Integrated-Project-2-2023-UVic-UCC/reflow-soldering/List of Materials.xlsx

PRODUCT | UNIT PRICE | UNITS | TOTAL PRICE | WEB | LINK
Converter AC/DC 5v | 3.67 | 1 | 3.67 | shoptronica | https://www.shoptronica.com/fuentes-ac-dc/5874-fuente-conmutada-ac-dc-5v-2a-36x17mm-0689593940483.html
convertidor ac dc 5, 12 | 3.25 | 1 | 3.25 | aliexpres | https://es.aliexpress.com/item/1005004882184300.html?_t=pvid%3A0c7acc52-9918-41fa-87ab-2f479e853282
Sintetic wool Aisolaytor with an aluminium paper on top
Relay SSR 220v-5v | 9.99 | 1 | 9.99 | Amazon | https://www.amazon.es/Diymore-M%C3%B3dulo-Arduino-24V-380V-SSR-40DA/dp/B08FWWRK2Y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
Termistor 100 ohms, 300ºC | 1.61 | 1 | 1.61 | aliexpres | https://es.aliexpress.com/item/32436136885.html?_t=pvid%3A84f9d991-ff43-4abf-a58f-0a8a653c939a
AC port | 1.14 | 1 | 1.14 | shoptronica | https://www.shoptronica.com/conectores-de-enchufes-clavijas-de-luz-iec/5358-base-enchufe-de-luz-iec-60320-macho-cs-8944748458223.html
Arduino uno |  | 1 | 0 | Rspro | https://es.rs-online.com/web/p/arduino/7154081?tpr=1
Hot plate 500W | 10.3 | 1 | 10.3 | shoptronica | https://www.shoptronica.com/circuitos-electronicos/6020-placas-de-calentamiento-para-soldar-led-star-220v-0689594049628.html
LSD Screen 16x2 | 3.59 | 1 | 3.59 | solectro | https://solectroshop.com/es/pantalla-lcd/739-pantalla-lcd-16x2-1602-hd44780-retroiluminado-fondo-azul.html
