Integrated-Project-2-2023-UVic-UCC/reflow-soldering/Assembly.stp

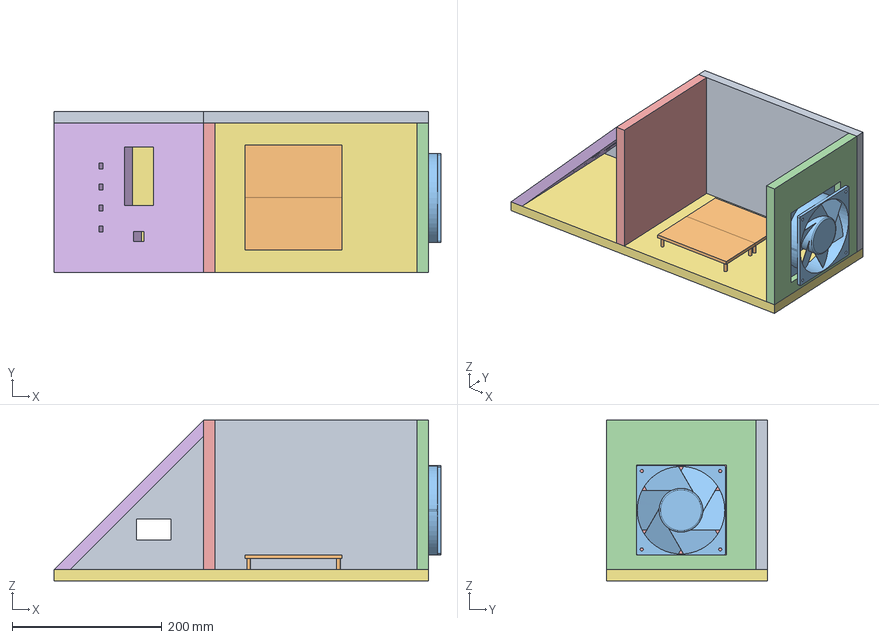
[picture p14: CAD file, 2023-06-04]
Assembly.stp
517.0 x 215.0 x 215.0 mm
Tapa lateral
Placa soldadura x 2
Ventilador
Soport ventilador
Soport panell
Panell control
Base
