Integrated-Project-2-2023-UVic-UCC/reflow-soldering/SideCover.stp

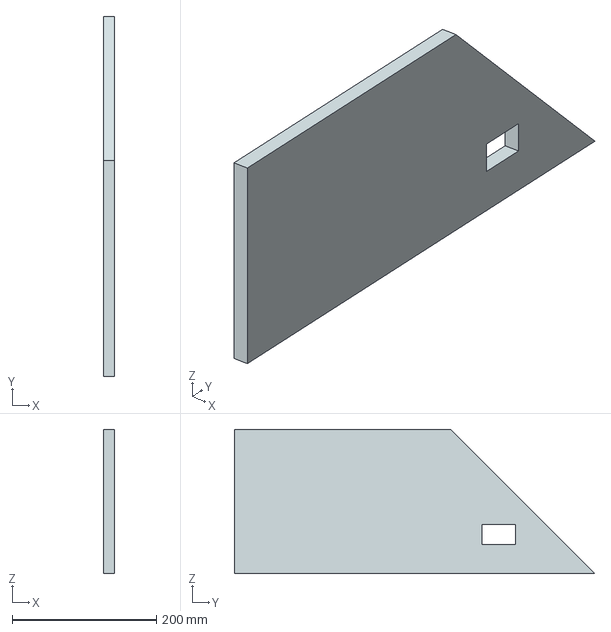
[picture p15: CAD file, 2023-06-04]
SideCover.stp
15.0 x 500.0 x 200.0 mm
