Integrated-Project-2-2023-UVic-UCC/reflow-soldering/Base (2).stp

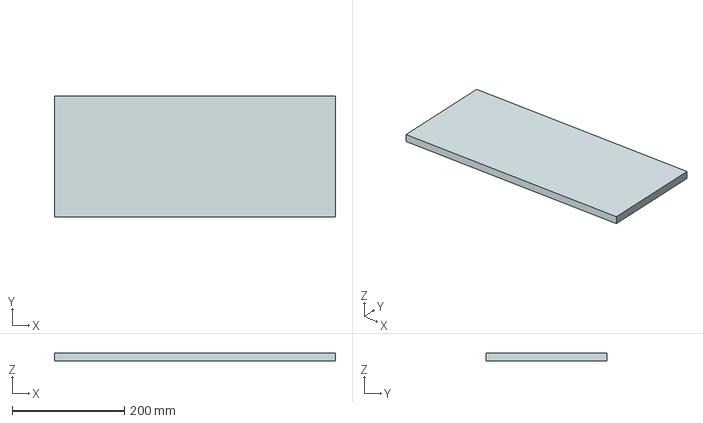
[picture p16: CAD file, 2023-06-04]
Base (2).stp
500.0 x 215.0 x 15.0 mm
