Integrated-Project-2-2023-UVic-UCC/reflow-soldering/plug.stl

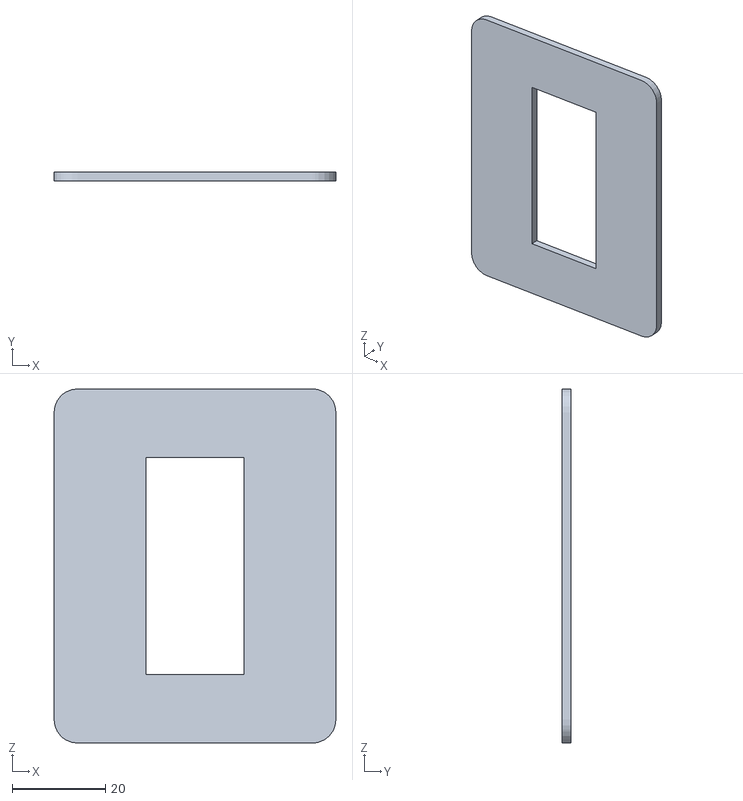
[picture p17: CAD file, 2023-06-04]
plug.stl
60.5 x 2.00 x 76.0
