Integrated-Project-2-2023-UVic-UCC/reflow-soldering/ControlPanel.stp

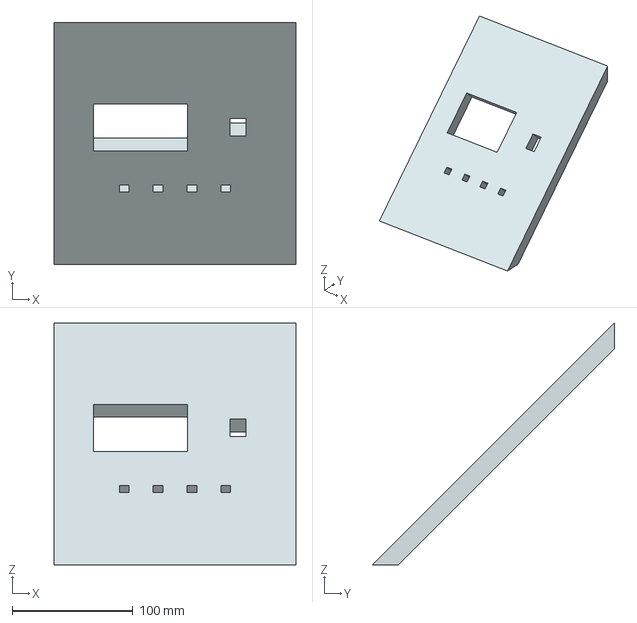
[picture p18: CAD file, 2023-06-04]
ControlPanel.stp
200.0 x 200.0 x 200.0 mm
