Integrated-Project-2-2023-UVic-UCC/reflow-soldering/FanSupport.stp

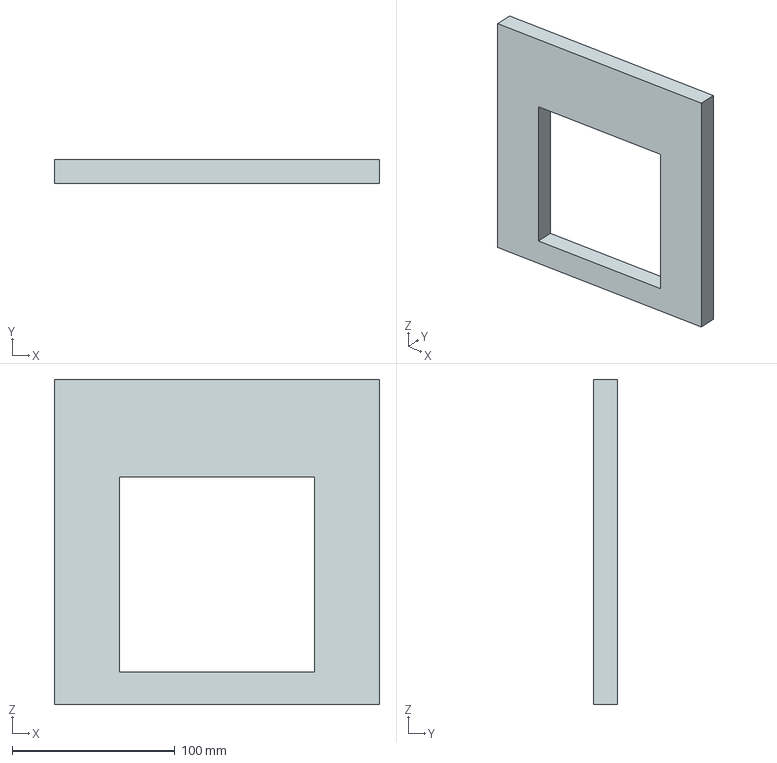
[picture p19: CAD file, 2023-06-04]
FanSupport.stp
200.0 x 15.0 x 200.0 mm
