Integrated-Project-2-2023-UVic-UCC/reflow-soldering/HotPlate.stp

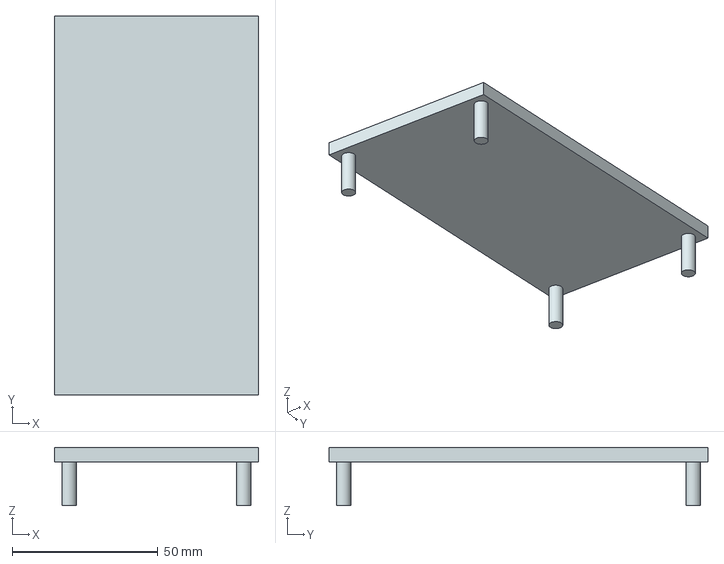
[picture p20: CAD file, 2023-06-04]
HotPlate.stp
70.0 x 130.0 x 20.0 mm
