Integrated-Project-2-2023-UVic-UCC/reflow-soldering/Fan.stp

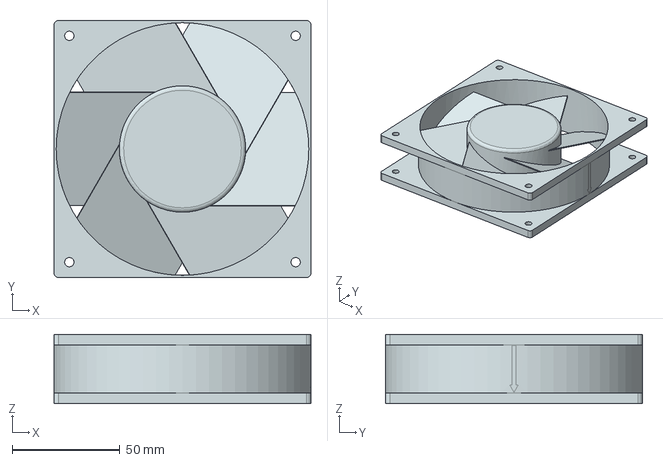
[picture p21: CAD file, 2023-06-04]
Fan.stp
119.0 x 119.0 x 32.0 mm
