Integrated-Project-2-2023-UVic-UCC/reflow-soldering/ControlPanel (2).stp

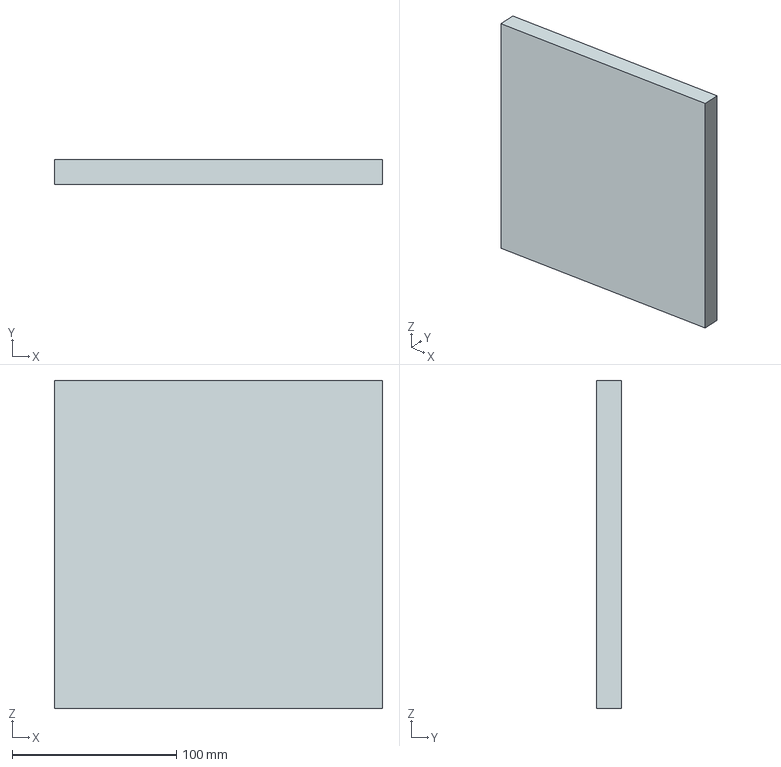
[picture p22: CAD file, 2023-06-04, an earlier design]
ControlPanel (2).stp
200.0 x 15.0 x 200.0 mm
