Integrated-Project-2-2023-UVic-UCC/reflow-soldering/HotPlate_UserManual.pdf

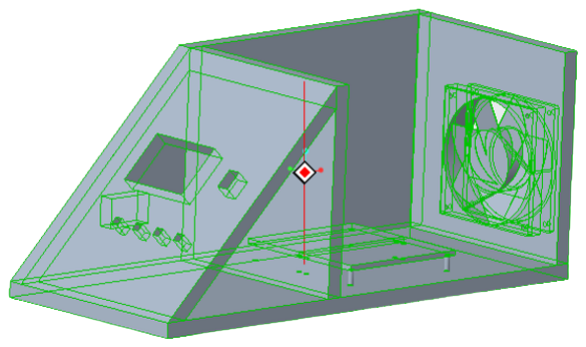
[picture p23: figure]

# REFLOWING HOT PLATE MACHINE

I N T E G R A T E D P R O J E C T II

SAFETY WARINIGS | HOW TO USE IT

Use only for soldering psb
components

If one of the hot plates breaks or cracks, unplug it immediately to avoid electric shock.

This appliance is not designed to operate with an external timer (not built into the appliance) or a separate remote control system.

The device and its accessible parts may become hot during operation, avoid touching the heating elements.

Children under 8 years of age should be kept away from the hob unless they are under constant supervision. They should ONLY use the device under supervision or if they have received proper instructions on how to use the device and understand its dangers.

Do not store objects in the hot plates.

If the power cord is damaged, it must be replaced.

Put the device that
requires welding on the
plate and apply the
corresponding fixing
paste

1

Close the protective

2

cover to the user

Correctly connect the
power inlet and switch
on the device

3

Wait for the welding
process to finish.
From the screen it will
be indicated going back
to the main menu

4

# MORE INFO

# MANTEINANCE

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

CARRER DE LA LAURA, 13, 08500 VIC

|EN| Instructions for use, manteinance and safety warnings.

Do not steam clean this device.

Cleaning and maintenance must not be carried out by children without supervision. Children must not play with the device.

The device requires superficial cleaning after each use with dry and moisture-free utensils.
