Integrated-Project-2-2023-UVic-UCC/reflow-soldering/(threads)

Thread 1 (2023-02-16):

Things missing

JuniperSans, 2023-02-16:
- [ ] shopping list
- [ ] Cad design
- [ ] Start documentation

Thread 4 (2023-02-16):

Design of the circuit

Ana343Carolina, 2023-02-16:
Doing the design of the circuit on CircuitLab and maybe Tinkercad(just for having an ideia about how's going to work with the arduino)

Ana343Carolina, 2023-03-08:
- [ ] Put all the components according to the project
- [ ] Design the ones that are missing in the general library
- [ ] Connect all the components correctly
- [ ] Put the symbols if necessary
- [ ] Adding in the library the components that are missing if necessary

JuniperSans, 2023-03-08:
As we may change the hot plate component, we may consider that the circuit could have some modifications.

Ana343Carolina, 2023-03-09:
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

Change the thermistor to a termopar MAX6675

Ana343Carolina, 2023-03-13:
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
For now, the circuit it is like this. Maybe I have to change the buttoms connected to arduino, but I don't know yet whichport is going to be connected

Ana343Carolina, 2023-03-16:
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
I've changed the names that were wrong, I still have to change the name of the dispaly baord, but it is on my library and I'm trying to figure out how to do it wihtout deleting and making again the connections.

Ana343Carolina, 2023-03-28:
There is some changes between the display board and the arduíno. It´s going to have resistor between some ports.
Also the relay was connected on a wrong way, so it has some changes

Ana343Carolina, 2023-03-28:
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

Ana343Carolina, 2023-03-28:
I need to find a way to connect the resistors between the display board and the arduino
(all the ports that are connected are correct, is just missing the resistors)

Ana343Carolina, 2023-03-28:
Also the buttoms are just to represent, in the next weeks when we connect them I will change on KiCad

Ana343Carolina, 2023-04-13:
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

I started the connexions between the display and the arduino, with all the pins and the resistors between then. I will try to rearange to make a bigger space between the arduino and the display board, to not look so messy.
I also get done the transistor connected to the relay, but is missing the part to connect to arduino.

Ana343Carolina, 2023-04-20:
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

Final circuit, but if would have any change I will do it again

Ana343Carolina, 2023-05-04:
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

this is the final schematic, all connected correctly

Ana343Carolina, 2023-05-04:
Alerady upload on Code

Thread 7 (2023-02-22):

Input/output device idea

moises-garin, 2023-02-22:
I would like you to consider to use a screen in your project instead of a simple text display. In particular have a look at the following screens (similar but different size):
[https://www.adafruit.com/product/2050](https://www.adafruit.com/product/2050)
[https://www.adafruit.com/product/1770](https://www.adafruit.com/product/1770)

These might be nice to show graphically the temperature profile and, since they are touch sensitive, also for the user input (no need for buttons). In principle these should be compatible with both, arduino and ESP.

Thread 15 (2023-02-28):

Design of the circuit

Ana343Carolina, 2023-02-28:

Ana343Carolina, 2023-03-08:
- Puting all the components on kicad (look for the most likely ones)
- Editing the symbols
- Do the connection between the components

Ana343Carolina, 2023-03-28:
[hot-plate-kicad-2023-03-26_211435.zip](https://github.com/Integrated-Project-2-2023-UVic-UCC/reflow-soldering/files/11090508/hot-plate-kicad-2023-03-26_211435.zip)

Thread 17 (2023-02-28):

Create a simple program

Ana343Carolina, 2023-02-28:

JuniperSans, 2023-03-08:
I've search on different PID programs for controling temperature and, i know how to control the graphics part

Thread 23 (2023-03-09):

Research information about the LCD screen

JuniperSans, 2023-03-09:
Model: *3'2 TFT SPI 240x320 V2.0*

- [ ] Showing graphics
- [ ] Touching

Ana343Carolina, 2023-05-02:
We succeded on the touching part, we made a program that we can choose the type of alloy and also shows the time and the temperature.

Thread 24 (2023-03-09):

Base CAD Design

JuniperSans, 2023-03-09:

Ana343Carolina, 2023-04-25:
In the last weeks we changed the design of the hot plate, for keeping all the components inside and also to have a fan in a good position that can help on the cooling process

Thread 26 (2023-03-16):

Datasheets of the components

Ana343Carolina, 2023-03-16:
Datasheet of the TERMOPAR
[MAX6675 - termopar.PDF](https://github.com/Integrated-Project-2-2023-UVic-UCC/reflow-soldering/files/10992917/MAX6675.-.termopar.PDF)

Ana343Carolina, 2023-03-16:
Datasheet of the Relay
[SSR-40DA-H-R - relay.PDF](https://github.com/Integrated-Project-2-2023-UVic-UCC/reflow-soldering/files/10992923/SSR-40DA-H-R.-.relay.PDF)

Ana343Carolina, 2023-03-16:
Datasheet of the Interruptor
[INTERRUPTOR-BALA.pdf](https://github.com/Integrated-Project-2-2023-UVic-UCC/reflow-soldering/files/10992938/INTERRUPTOR-BALA.pdf)

Ana343Carolina, 2023-04-18:
Datasheet of the Transistor
[transistor.PDF](https://github.com/Integrated-Project-2-2023-UVic-UCC/reflow-soldering/files/11263790/transistor.PDF)

Thread 28 (2023-03-17):

screen display circuit

JuniperSans, 2023-03-17:
Make a nice clean circuit and try some programs to make sure it works correctly

Ana343Carolina, 2023-05-09:
We are working on that now to adjust all the details and make a good screen that works well for our project

Thread 30 (2023-04-20):

Adding the fan to the project

Ana343Carolina, 2023-04-20:
In this part, we will add a fan to help the cooling time because it was a little bit slowly.
So if the transistor connected to the converter and the fan, we will have enough power to make the fan works and will be able to turn on and off.

Ana343Carolina, 2023-04-25:
Today we are going to test the fan with the converter and all the things connected. We have to see if our transistor are connected correctly to make sure that the 5V could get on the fan

Ana343Carolina, 2023-05-02:
All correct, the fan is connected well with the transistor and it's working as we wanted.

Thread 32 (2023-05-02):

Assembly the wood part

Ana343Carolina, 2023-05-02:
In this task, we get all the parts made by wood and assembly to have our final design of the hot plate (only the wood parts).

Ana343Carolina, 2023-05-02:
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

Ana343Carolina, 2023-05-02:
Today we started the painting part of the wood, we painted just one hand and tomorrow it will be finished the details.

Thread 37 (2023-05-09):

Assemblying the wood part with the electrical part

Ana343Carolina, 2023-05-09:
In this task we have to finish the wood part, painting, screwing and make it all look nice.

Ana343Carolina, 2023-05-09:
We already paint the wood part and screwed all.
Now we are putting the electrical stuff inside of the wood and adjusting the details.
