Integrated-Project-2-2023-UVic-UCC/reflow-soldering/temperaturegraphic.pdf

# Temperature

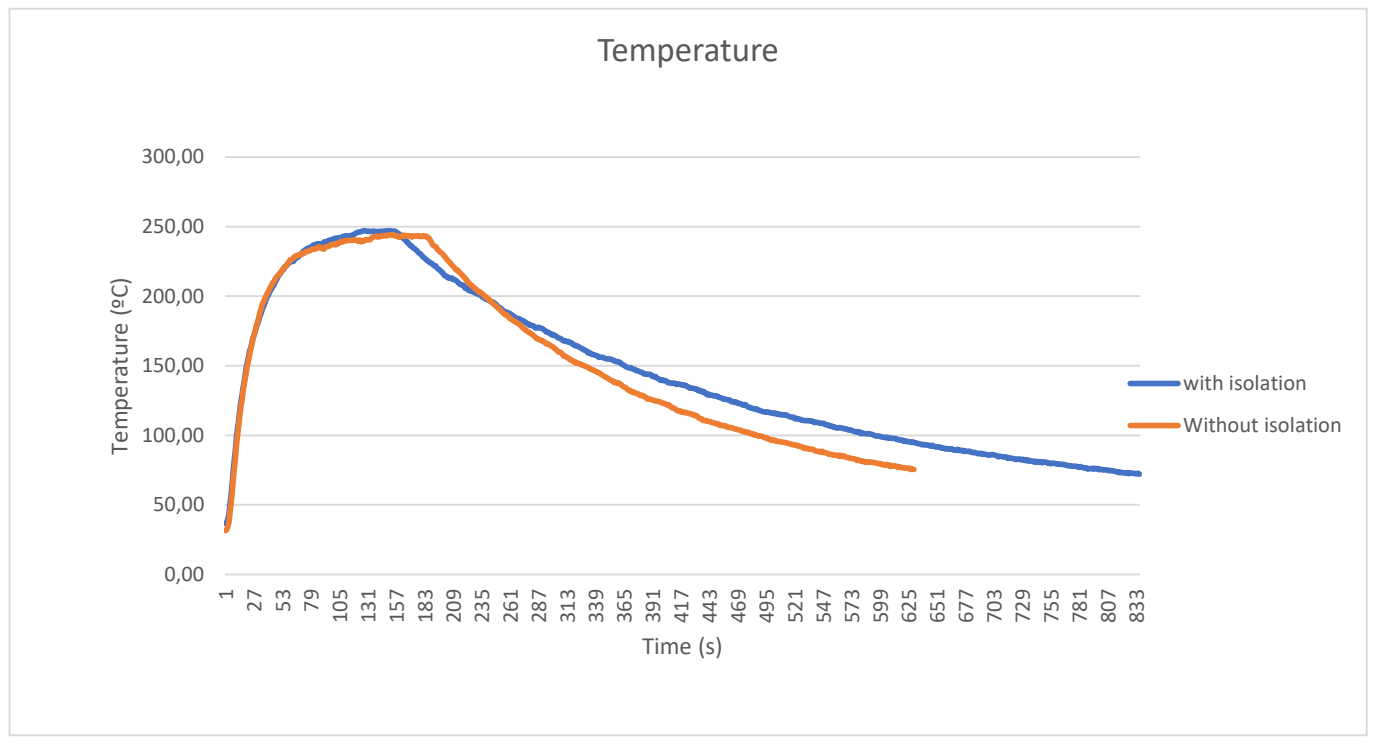
[picture p26: page 1]
Temperature (ºC); Time (s); with isolation; Without isolation
