Integrated-Project-2-2023-UVic-UCC/reflow-soldering/Base.pdf

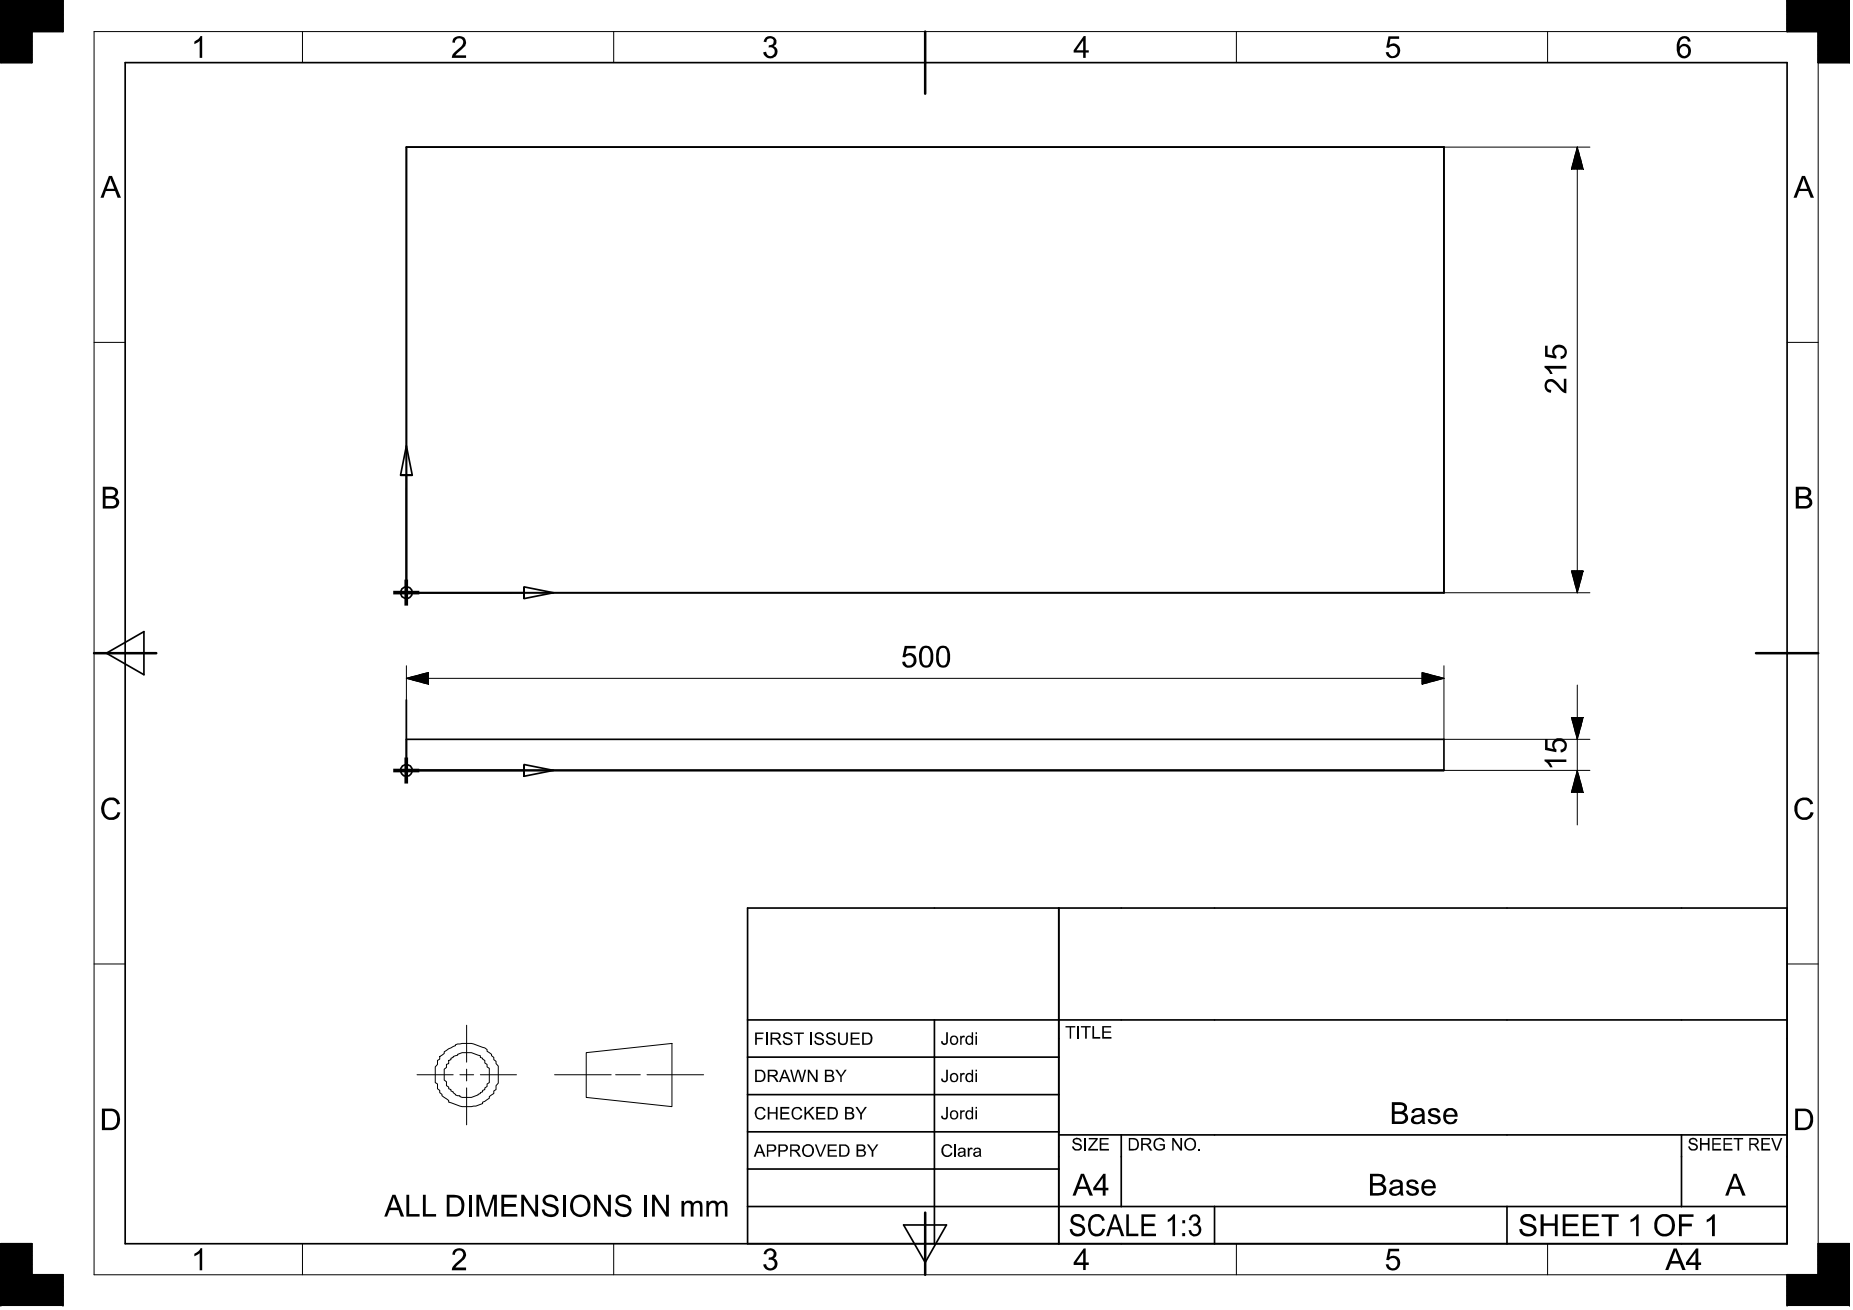
[picture p27: page 1]
