Integrated-Project-2-2023-UVic-UCC/reflow-soldering/Panell control.pdf

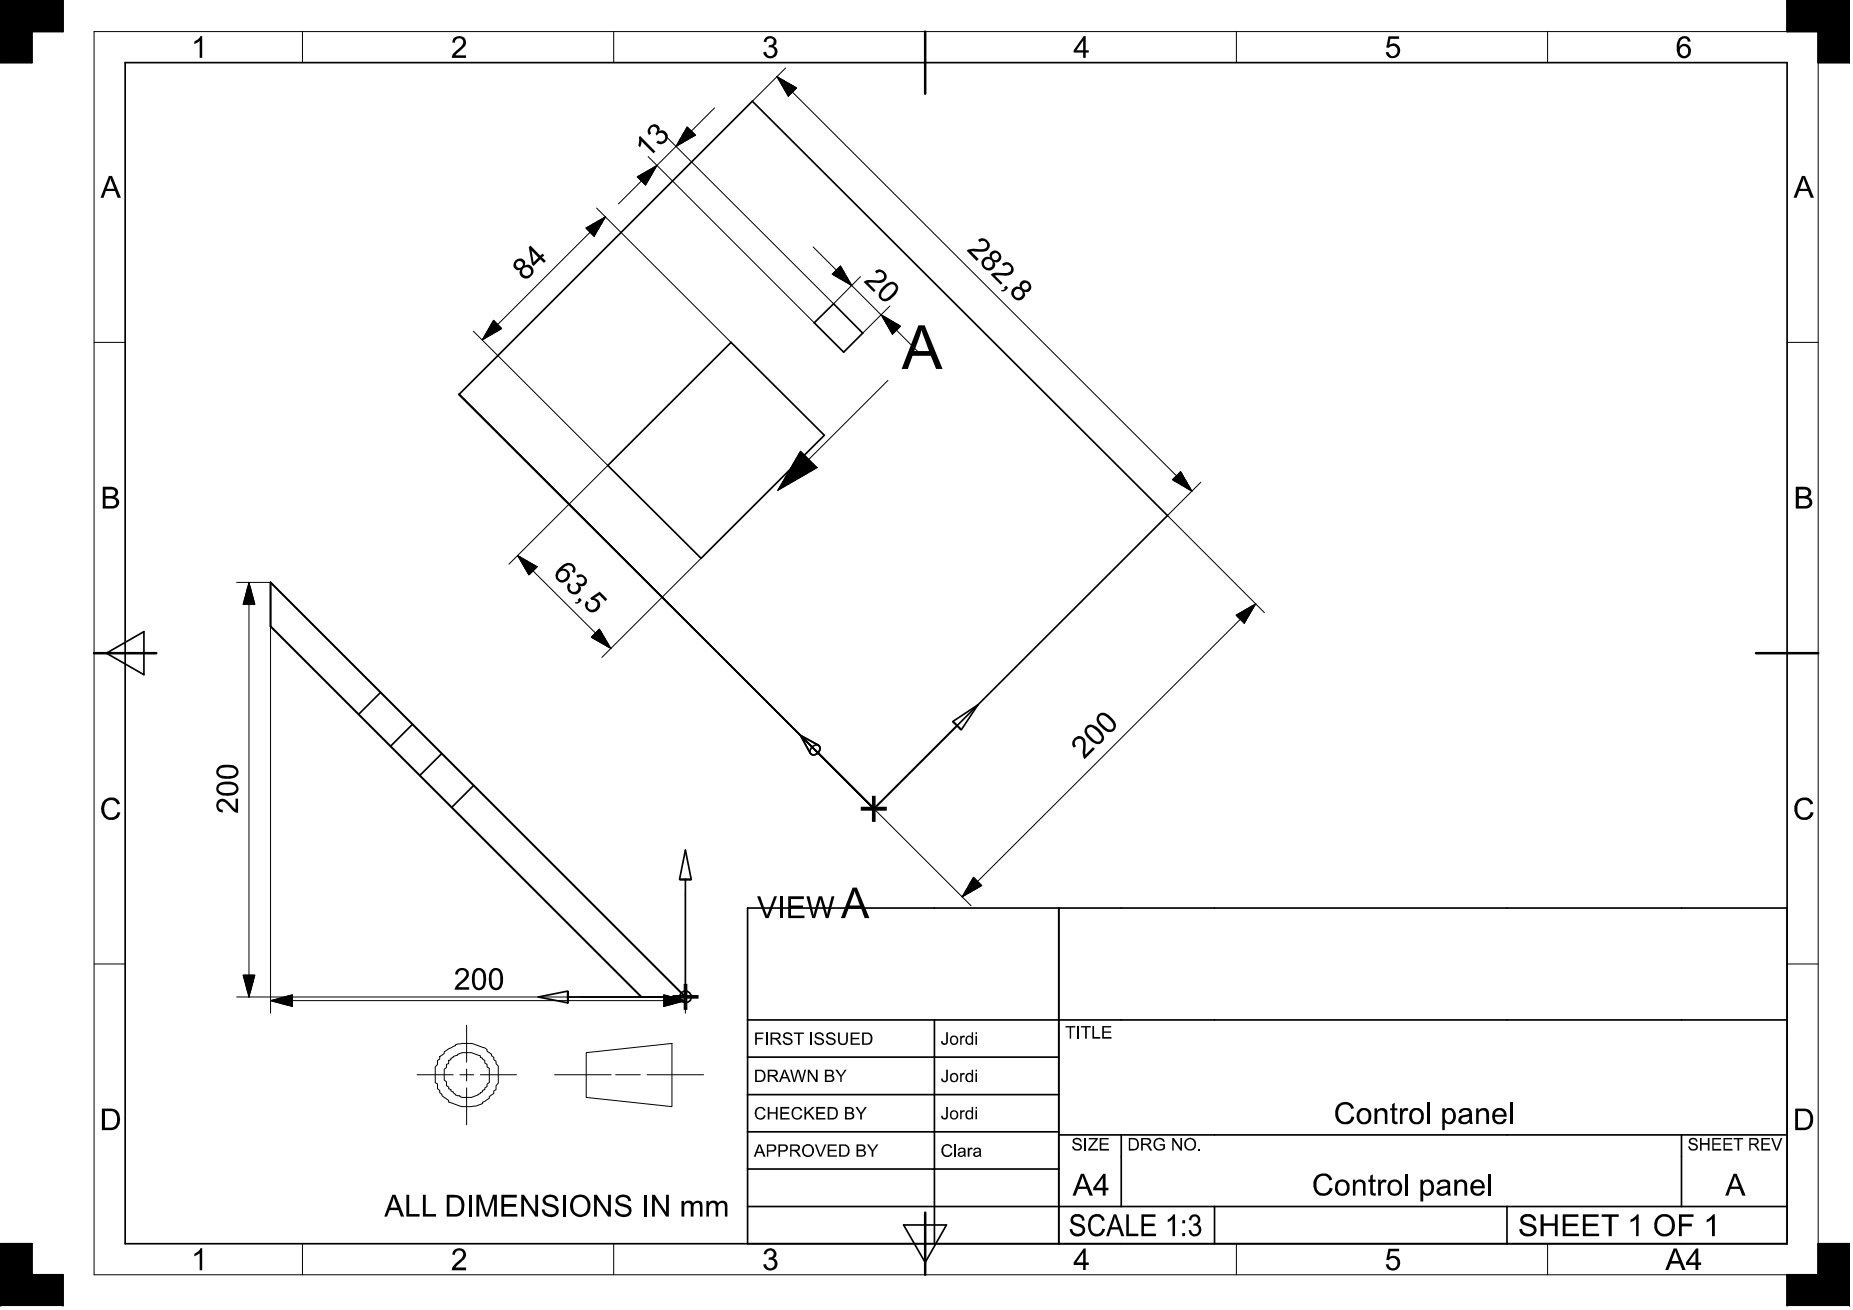
[picture p28: page 1]
