Integrated-Project-2-2023-UVic-UCC/reflow-soldering/Soport panell.pdf

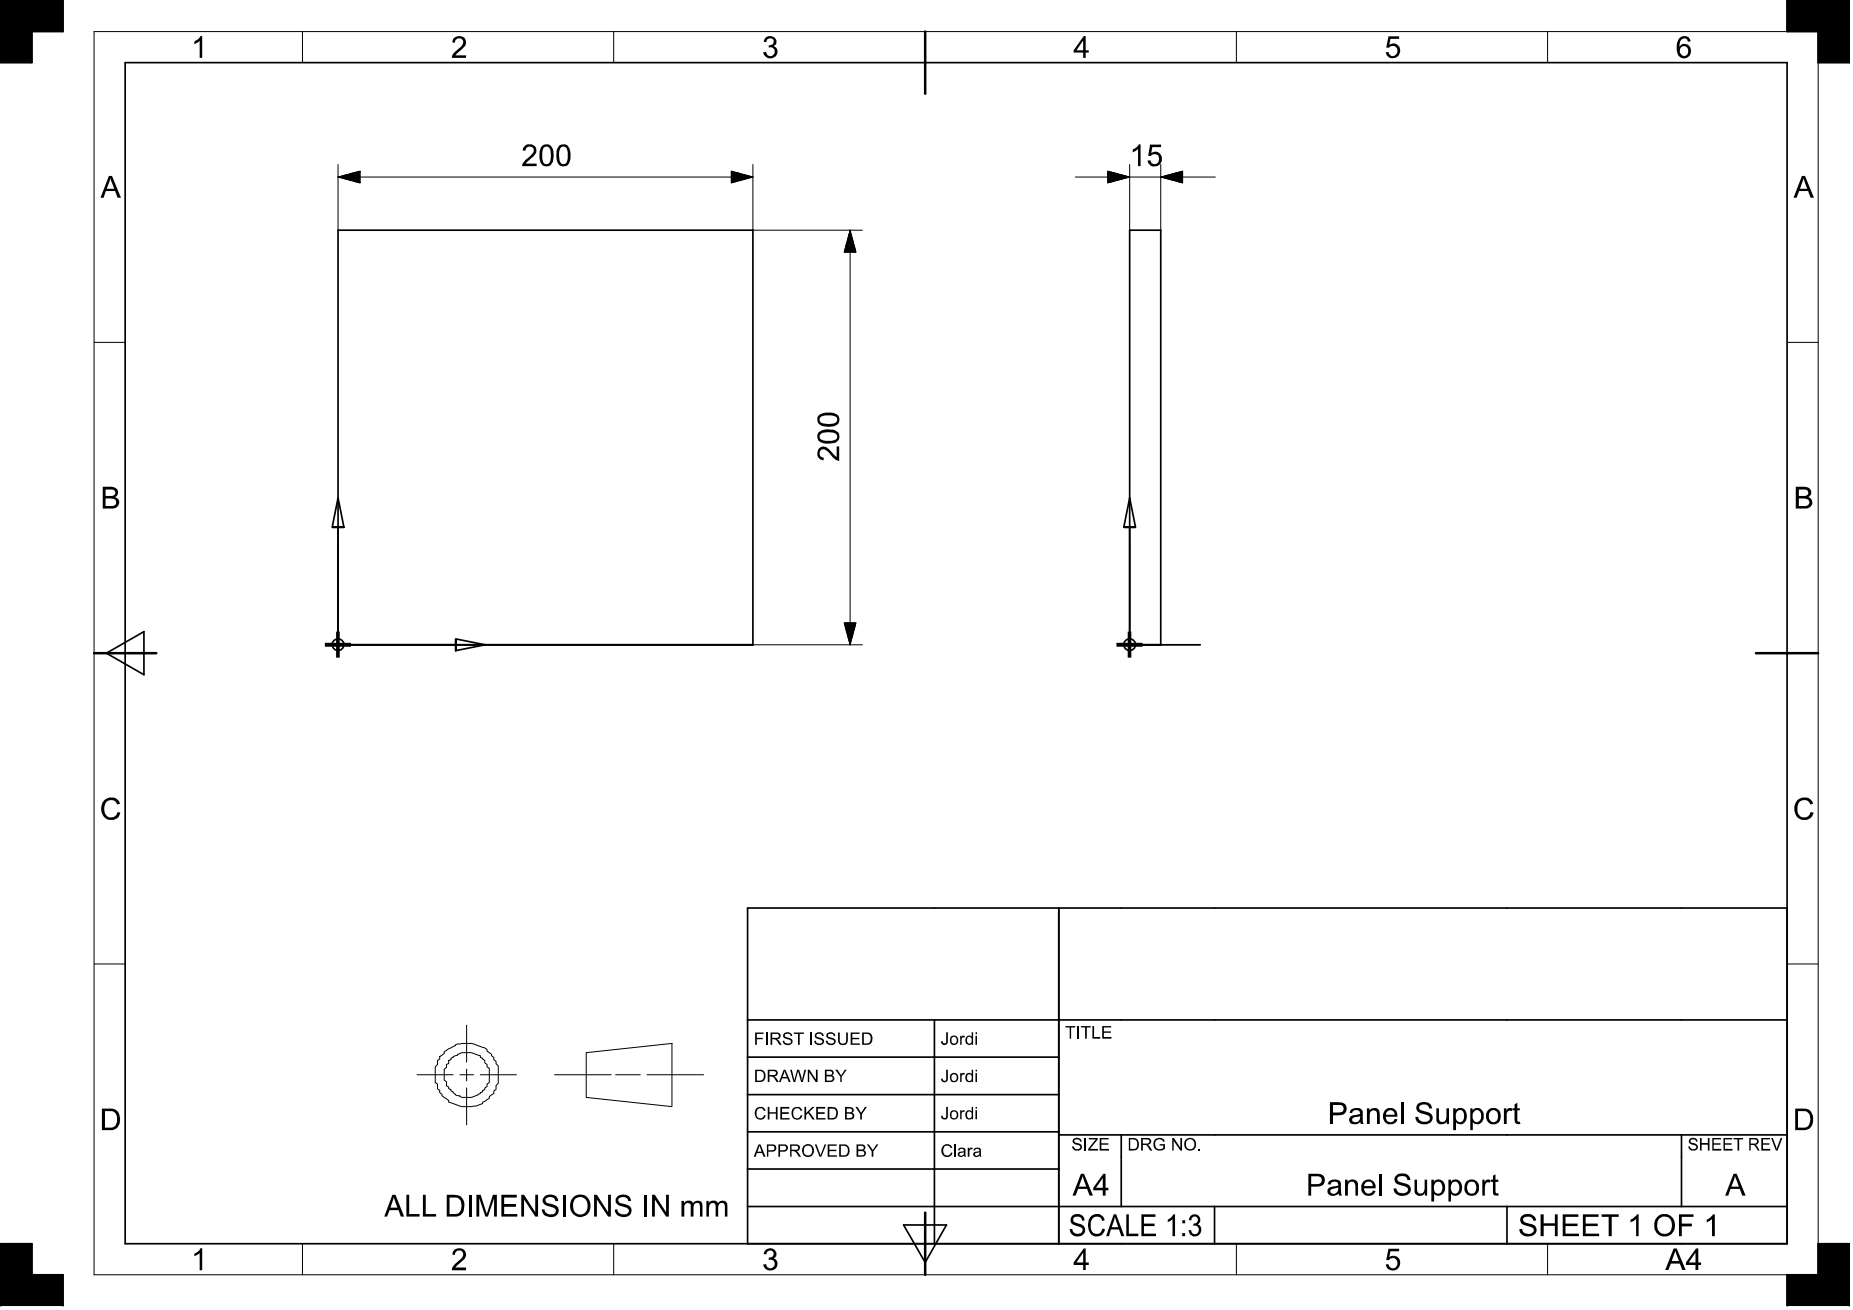
[picture p29: page 1]
