Integrated-Project-2-2023-UVic-UCC/reflow-soldering/Soport ventilador.pdf

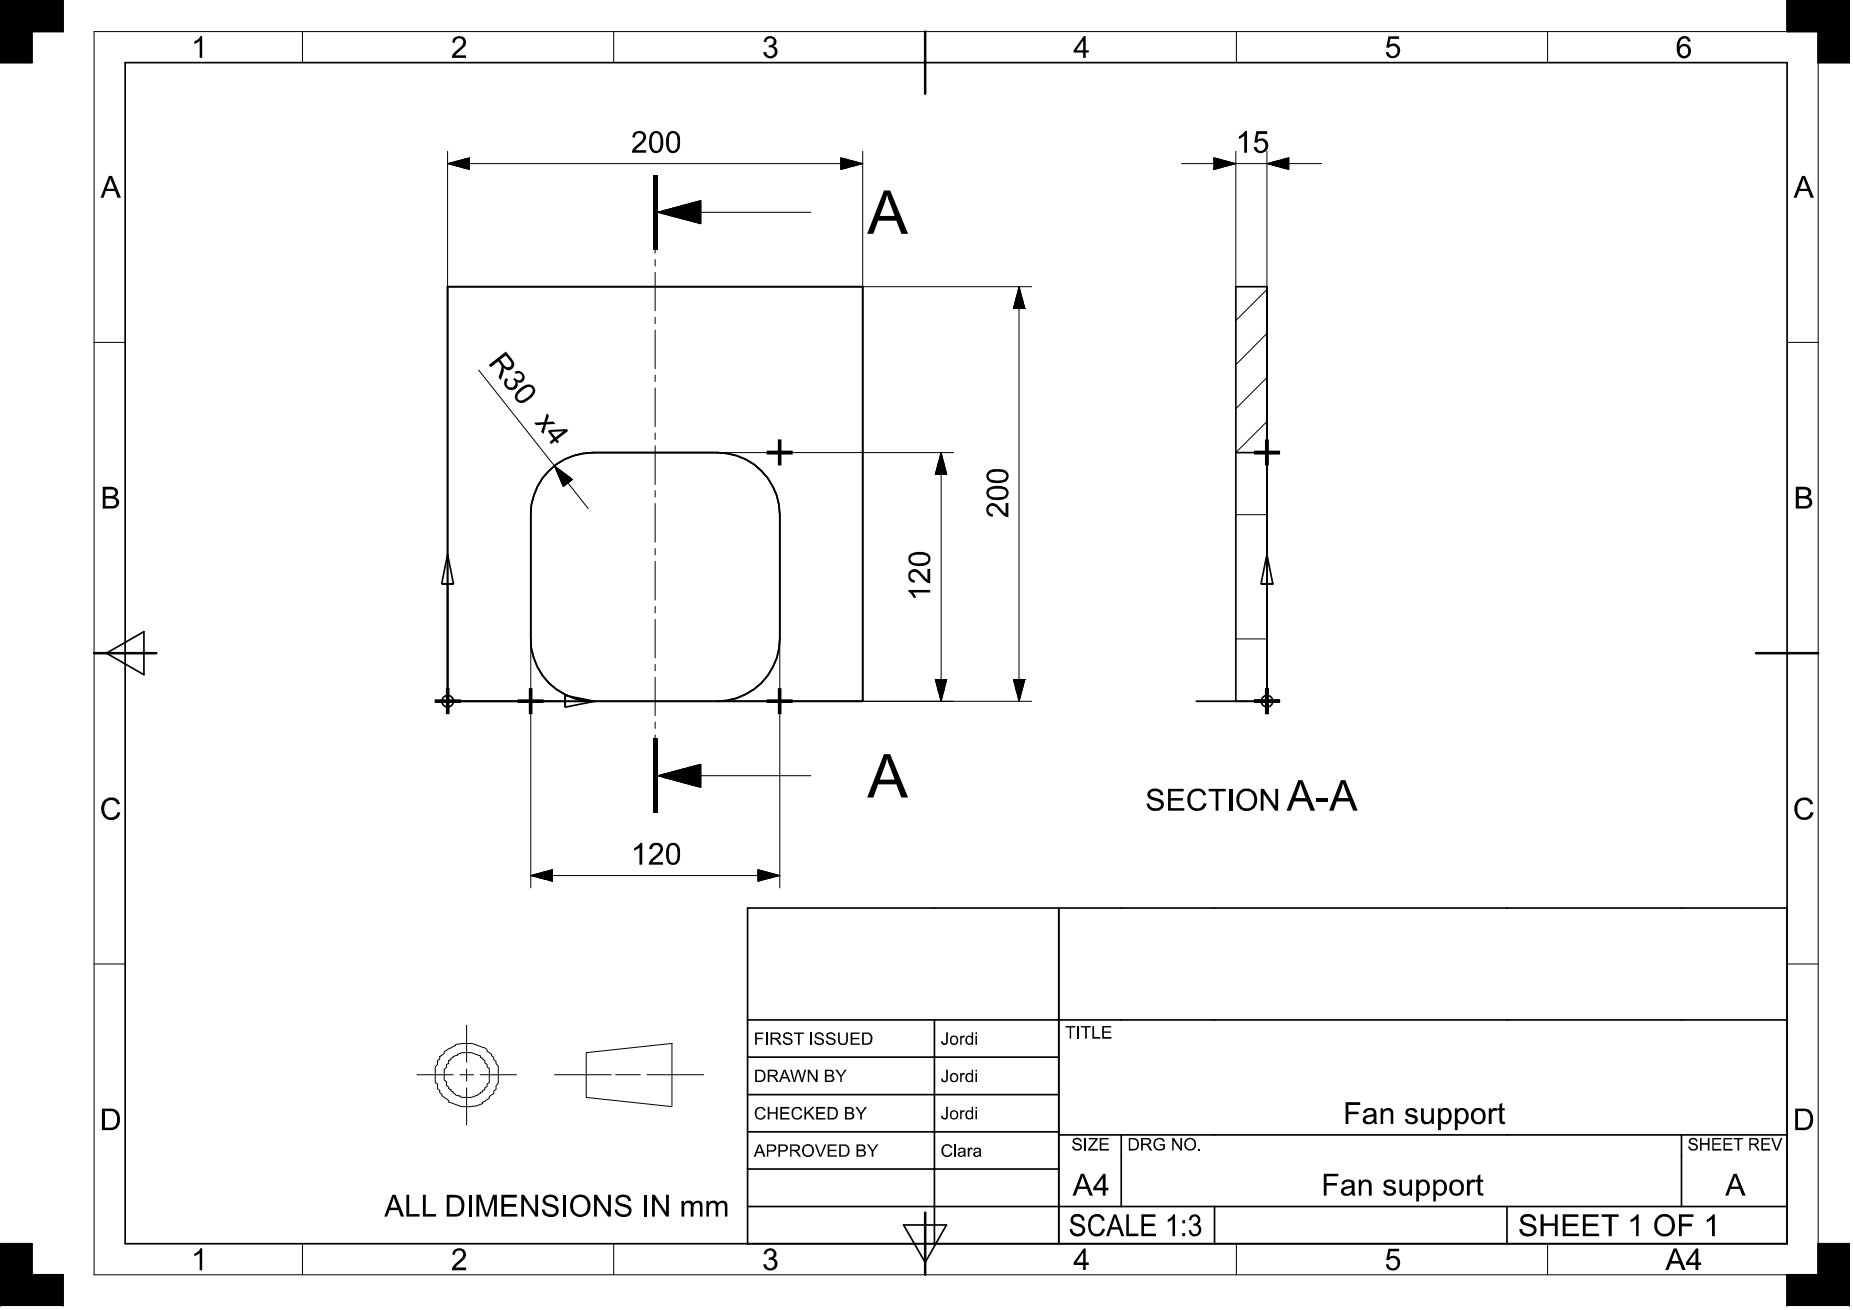
[picture p30: page 1]
