Integrated-Project-2-2023-UVic-UCC/reflow-soldering/Tapa lateral.pdf

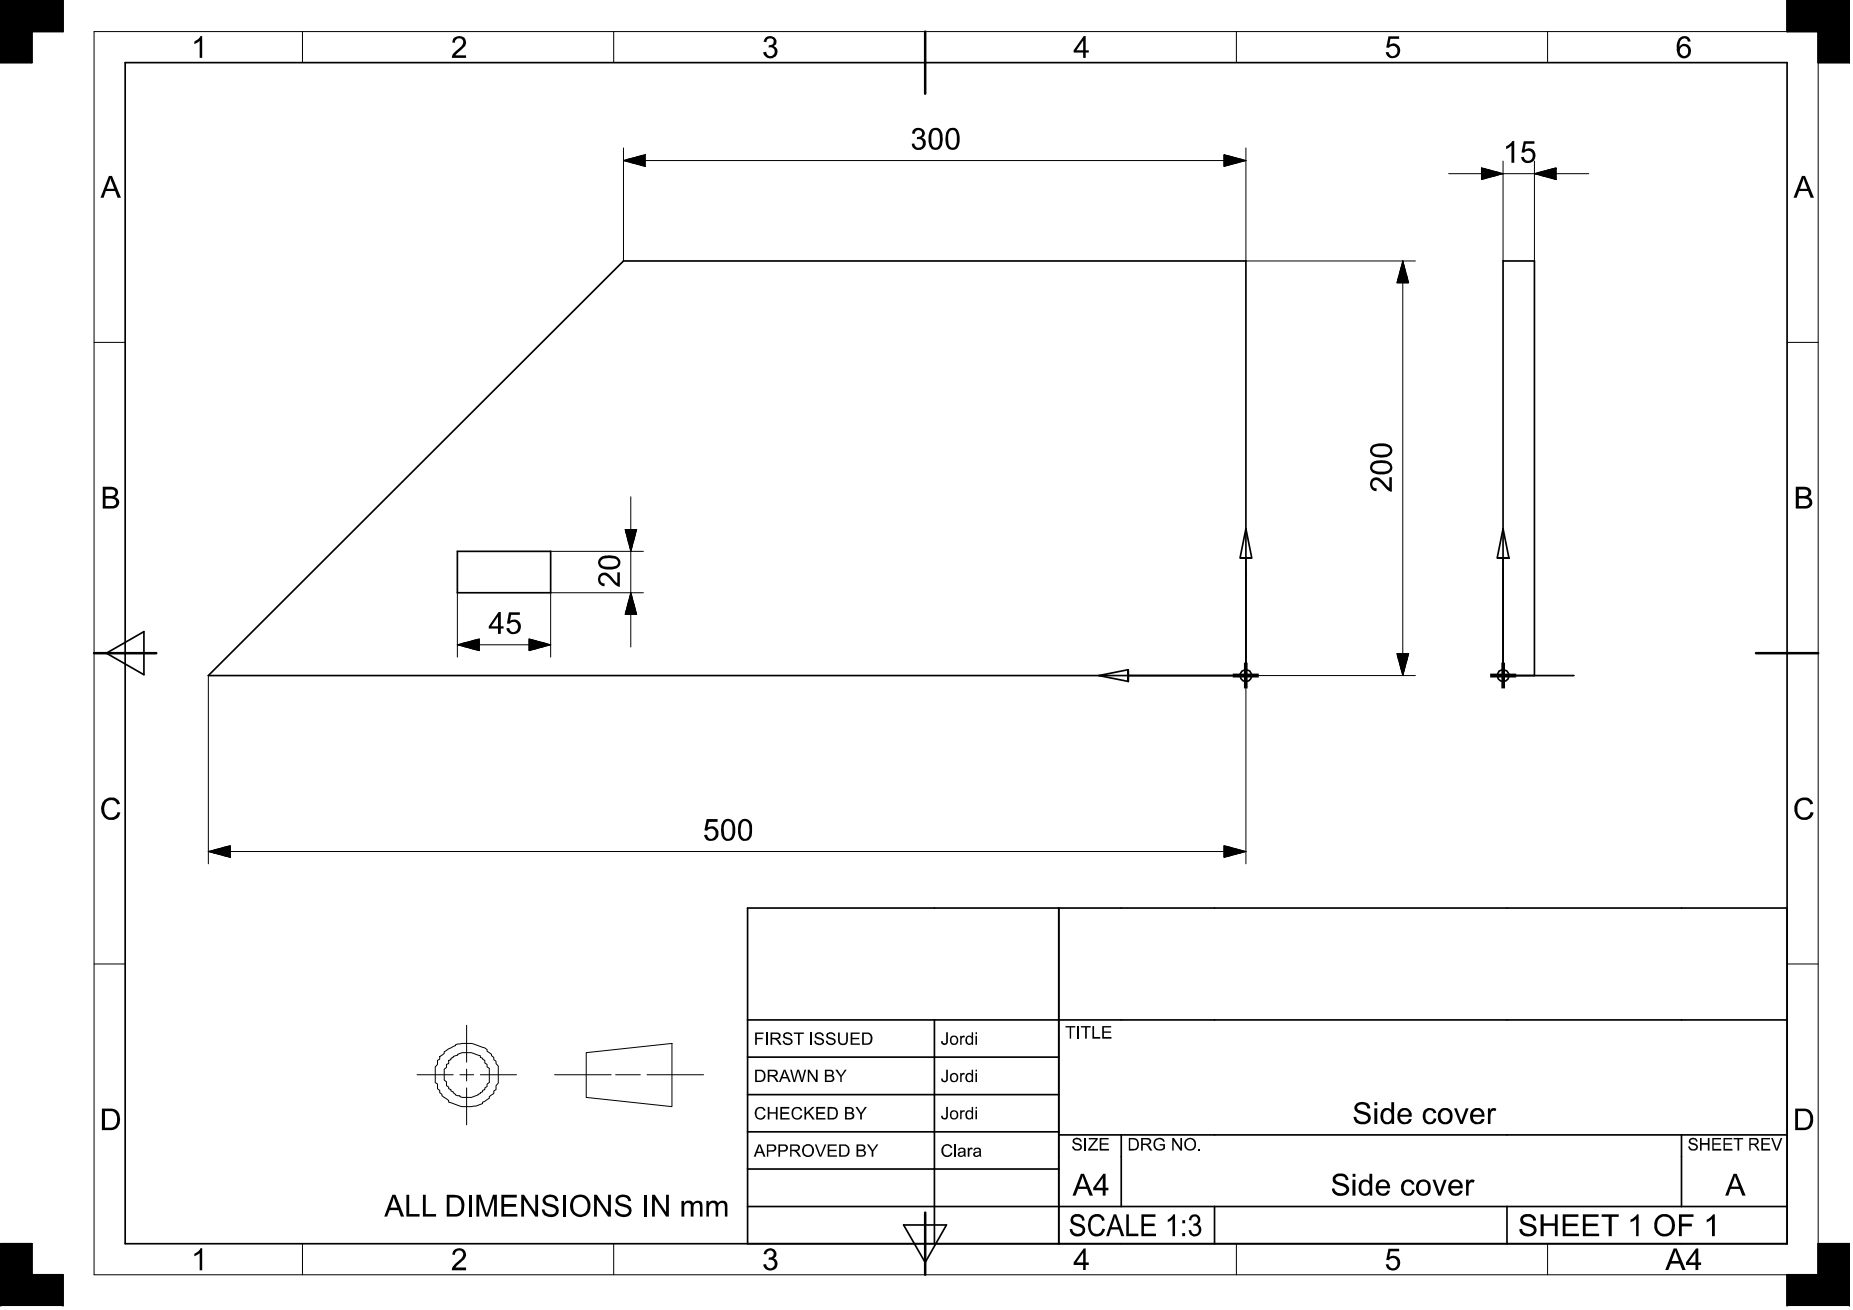
[picture p31: page 1]
