Integrated-Project-2-2023-UVic-UCC/reflow-soldering/ENGENIERINGDRAW_CASE.pdf

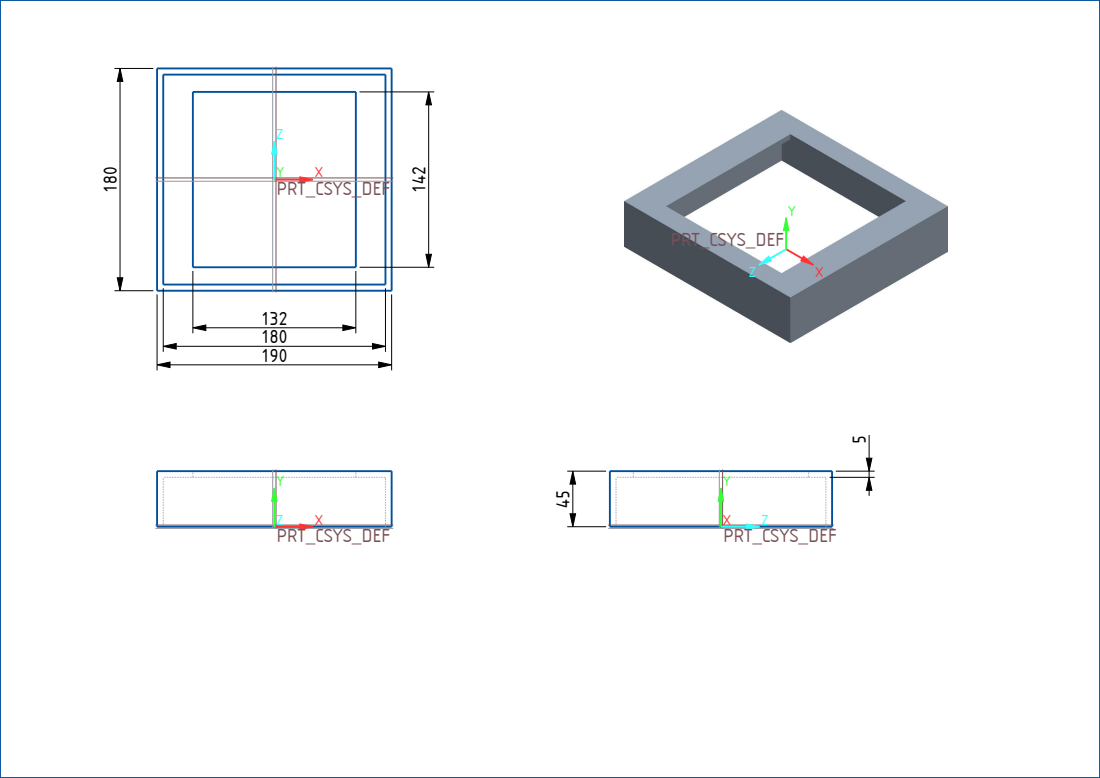
[picture p32: page 1]
PRT_CSYS_DEF; Z PRT_CSYS_DEF

PRT_CSYS_DEF
