Integrated-Project-2-2023-UVic-UCC/reflow-soldering/hot-plate-kicad_final.kicad_sch

## KiCad design hot-plate-kicad_final.kicad_sch (2023-06-05)

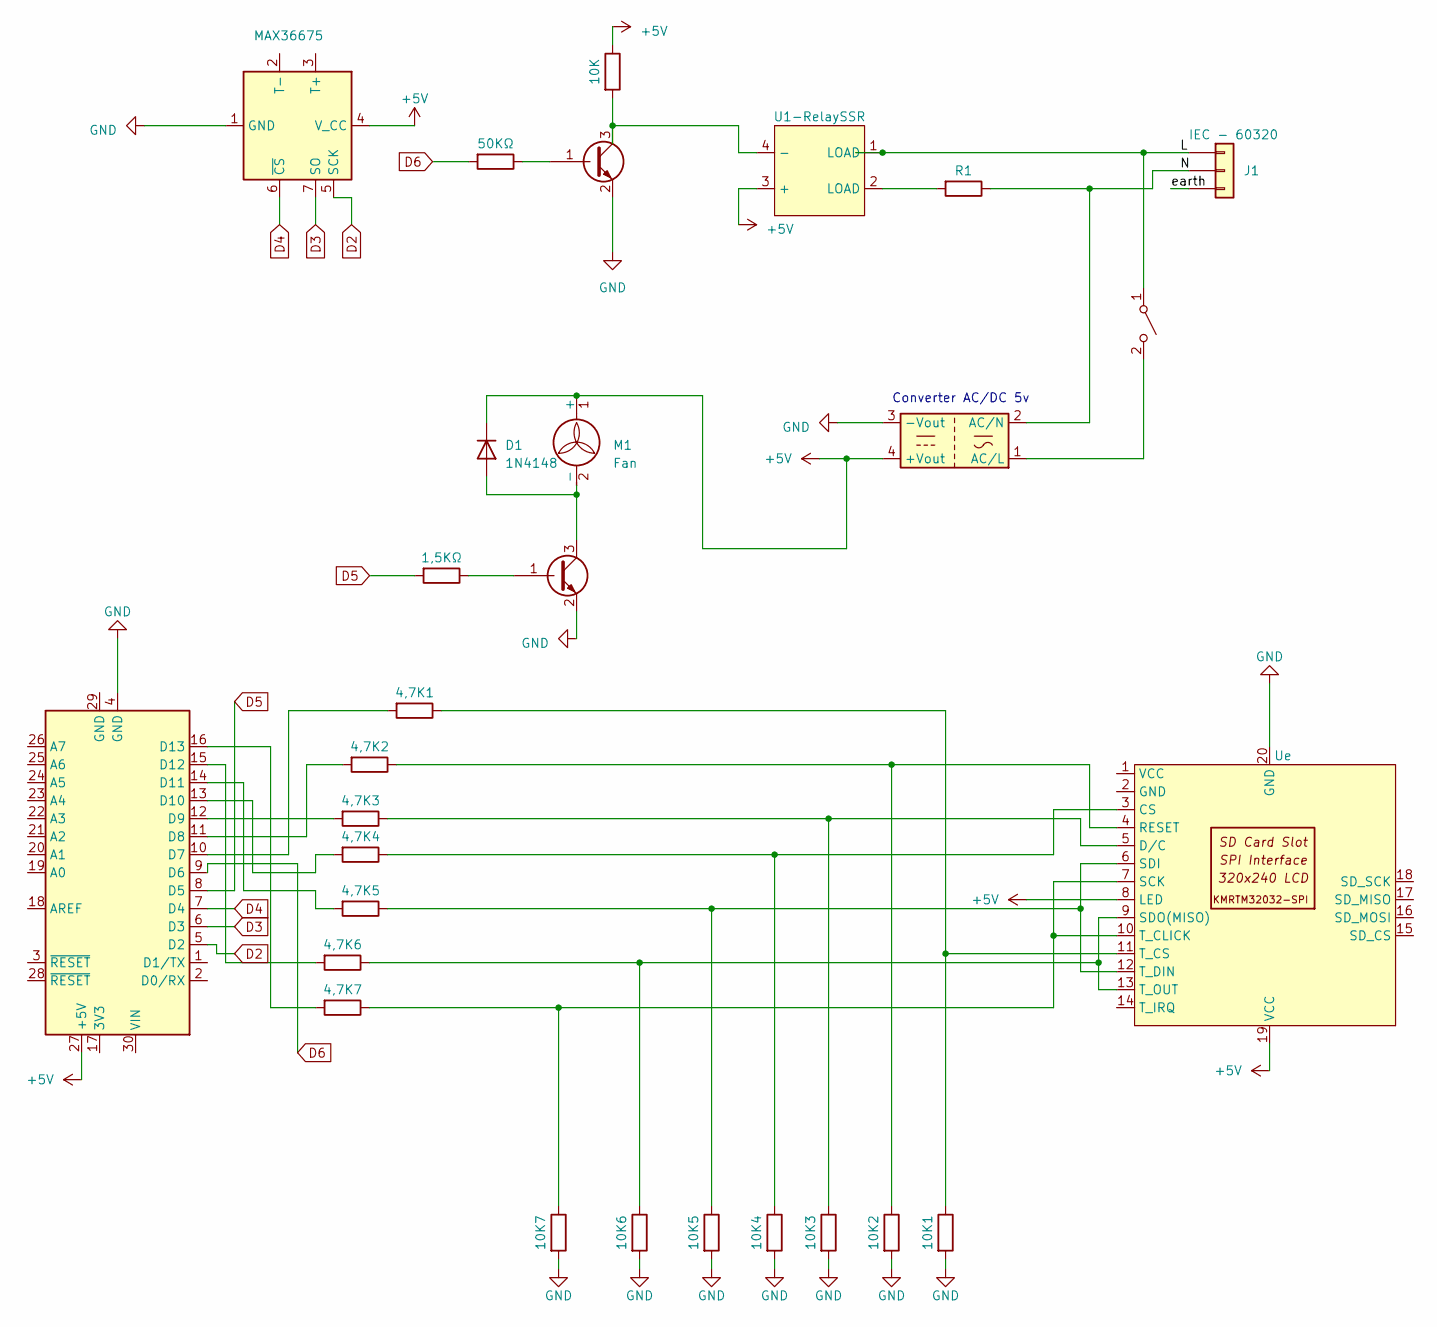
[picture p33: schematic hot-plate-kicad_final.kicad_sch]

Parts:
1,5KΩ, 4,7K1, 4,7K2, 4,7K3, 4,7K4, 4,7K5, 4,7K6, 4,7K7, 10K, 10K1, 10K2, 10K3, 10K4, 10K5, 10K6, 10K7, 50KΩ: R
A1: Arduino_Nano_v2.x; Arduino_Nano
D1: 1N4148; D_DO-35_SOD27_P7.62mm_Horizontal
J1: IEC - 60320
M1: Fan
PS1: HLK-PM01; Converter_ACDC_HiLink_HLK-PMxx
Q1, Q2: Q_NPN_BCE
R1: R
SW1: SW_DPST_x2
U1-RelaySSR: (no value)
U2: MAX36675; SOIC-8_3.9x4.9mm_P1.27mm
Ue: (no value)

Connections:
+5V: 10K.1, A1.27 (+5V), D1.1 (K), M1.1 (+), PS1.4 (+Vout), U1-RelaySSR.3 (+), U2.4 (V_CC), Ue.8 (LED), Ue.19 (VCC)
D2: A1.5 (D2), U2.5 (SCK)
D3: A1.6 (D3), U2.7 (SO)
D4: A1.7 (D4), U2.6 (~CS)
D5: 1,5KΩ.2, A1.8 (D5)
D6: 50KΩ.2, A1.9 (D6)
GND: 10K1.2, 10K2.2, 10K3.2, 10K4.2, 10K5.2, 10K6.2, 10K7.2, A1.4 (GND), PS1.3 (-Vout), Q1.2 (C), Q2.2 (C), U2.1 (GND), Ue.20 (GND)
L: J1.1, SW1.1 (A), U1-RelaySSR.1 (LOAD)
N: J1.2, PS1.2 (AC/N), R1.1
unnamed: 1,5KΩ.1, Q2.1 (B)
unnamed: 4,7K1.2, A1.10 (D7)
unnamed: 4,7K2.2, A1.11 (D8)
unnamed: 4,7K3.2, A1.12 (D9)
unnamed: 4,7K4.2, A1.13 (D10)
unnamed: 4,7K5.2, A1.14 (D11)
unnamed: 4,7K6.2, A1.15 (D12)
unnamed: 4,7K7.2, A1.16 (D13)
unnamed: 4,7K1.1, 10K1.1, Ue.11 (T_CS)
unnamed: 4,7K2.1, 10K2.1, Ue.4 (RESET)
unnamed: 4,7K3.1, 10K3.1, Ue.5 (D/C)
unnamed: 4,7K4.1, 10K4.1, Ue.3 (CS)
unnamed: 4,7K5.1, 10K5.1, Ue.6 (SDI), Ue.12 (T_DIN)
unnamed: 4,7K6.1, 10K6.1, Ue.9 (SDO(MISO)), Ue.13 (T_OUT)
unnamed: 4,7K7.1, 10K7.1, Ue.7 (SCK), Ue.10 (T_CLICK)
unnamed: 10K.2, Q1.3 (E), U1-RelaySSR.4 (-)
unnamed: 50KΩ.1, Q1.1 (B)
unnamed: D1.2 (A), M1.2 (-), Q2.3 (E)
unnamed: PS1.1 (AC/L), SW1.2 (B)
unnamed: R1.2, U1-RelaySSR.2 (LOAD)
earth: J1.3

Notes on the sheet:
Converter AC/DC 5v
