Integrated-Project-2-2023-UVic-UCC/reflow-soldering/serialthermocouple/serialthermocouple.ino

// this example is public domain. enjoy!
// www.ladyada.net/learn/sensors/thermocouple

#include "max6675.h"

int thermoDO = 2;
int thermoCS = 3;
int thermoCLK = 4;

MAX6675 thermocouple(thermoCLK, thermoCS, thermoDO);

  
void setup() {
  Serial.begin(9600);

  Serial.println("MAX6675 test");
  // wait for MAX chip to stabilize
  delay(500);
}

void loop() {
  // basic readout test, just print the current temp
  
   Serial.print("C = "); 
   Serial.println(thermocouple.readCelsius());

 
   delay(1000);
}
