Integrated-Project-2-2023-UVic-UCC/reflow-soldering/(commit log)

2023-02-16 About the Hot Plate Weder
2023-02-21 Add files via upload
    Those are the main components to start building and testing
    [List of Materials.xlsx]
2023-03-14 This is the code to mesure the temperature
    We use the library MAX6675
    [List of Materials.xlsx]
2023-03-14 CAD DESSIGN OF THE PART MADE BY WOOD
2023-03-14 Assembly and enginiering drawing
    Assembly and enginiering drawing done with PTC creo and CAD dessign of the aluminuim case
2023-03-23 Temperature Graphic
    Graphic that show the variaton of the temperature dependig on the time with isolation and without it.
2023-03-24 Create Electronical schematic
2023-03-24 Schematic of the circuit
    [hot-plate-kicad.kicad_sch]
2023-03-26 Results at testing the hot plates
2023-03-26 Engineering Draw of the new prototype
2023-04-20 This is the final circuit of the project
    Maybe in the next weeks could have some changes, but until now it's like this
    [hot-plate-kicad_final.kicad_sch]
2023-05-04 Add files via upload
    This is the final schematic with all connected according to the real circuit
    [hot-plate-kicad_final.kicad_sch]
2023-06-04 Cad model of the pieces
    [Assembly.stp, Base (2).stp, ControlPanel (2).stp, ControlPanel.stp, Fan.stp, FanSupport.stp, HotPlate.stp, SideCover.stp]
2023-06-04 Engineer draws of the case
2023-06-04 Hot Plate Manual
    This manual is really important to guide the user how to deal with the machine
2023-06-05 constant temperature PID
    Code done with moises to create a proper PID
2023-06-05 Final Code
    Code without error and with everything comented.
    It is an integration off all the codes done to create the final code running the machine.
    [ReflowSolderingCode.ino, pid.h]
2023-06-05 Final Schematic of the Electrical Part
    [hot-plate-kicad_final.kicad_sch]
2023-06-05 Instructables (in case that the link doesn't work)
